RASM80/SmartRelayController/images/README.md

overview

sms_test

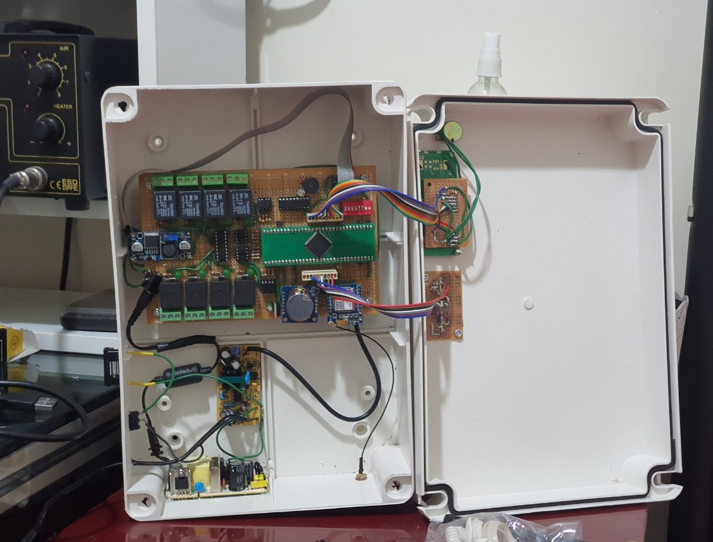
[picture p4: images/package.jpg]
packaging


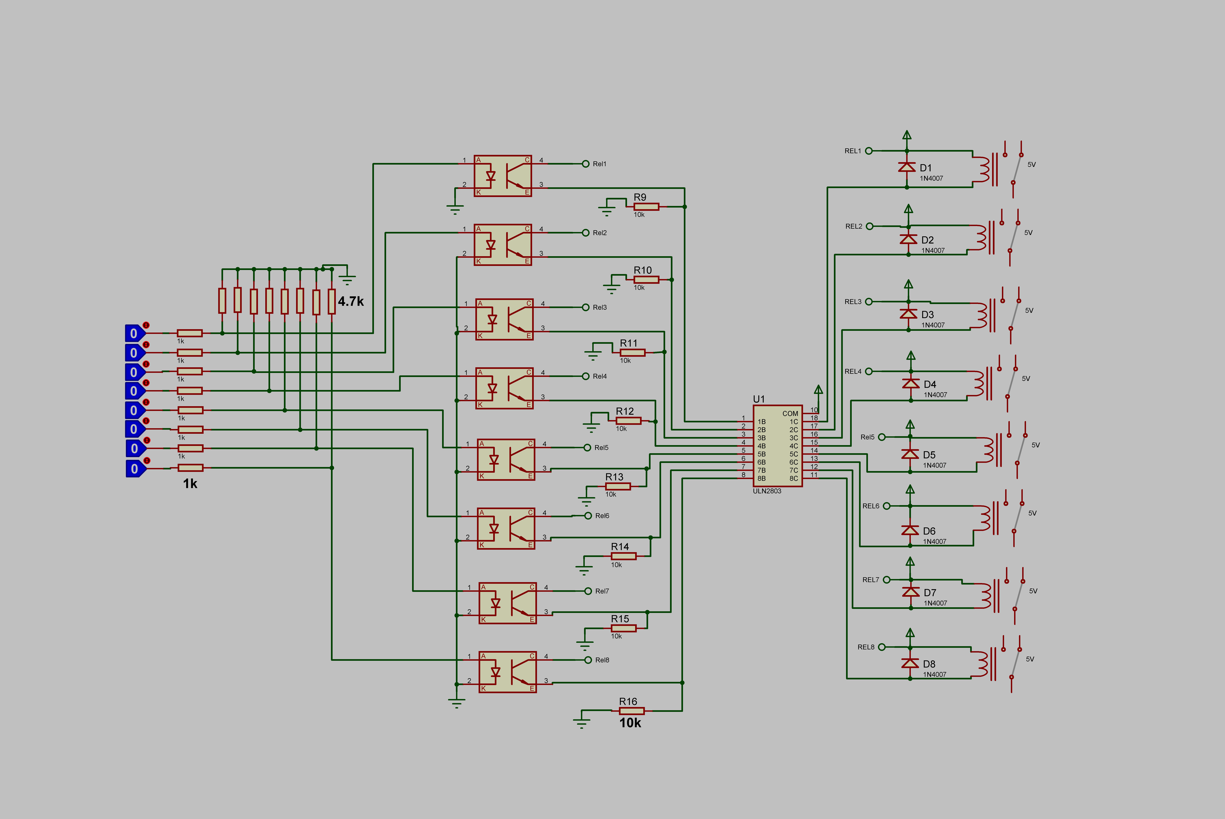
[picture p5: images/relay_board_schem.jpg]
relay_scheme


main_prot
