RASM80/SmartRelayController/hardware/proteus/relay_module_schamtics/README.md

**note**: Opto-couplers(PC817) are added to the circuit for safety and isolate two sides. (Control board and relays)

prot
