RASM80/SmartRelayController/hardware/proteus/main_schematic/README.md

prot
