RASM80/SmartRelayController/(list of files, drawings)

Other design files:
hardware/proteus/main_schematic/main_schem.pdsprj
hardware/proteus/relay_module_schamtics/relay.pdsprj
