RASM80/SmartRelayController/src/main/Initialize.c

void initialize(){

    DDRA=(1<<DDA7) | (1<<DDA6) | (1<<DDA5) | (1<<DDA4) | (1<<DDA3) | (1<<DDA2) | (1<<DDA1) | (1<<DDA0);
    PORTA=(0<<PORTA7) | (0<<PORTA6) | (0<<PORTA5) | (0<<PORTA4) | (0<<PORTA3) | (0<<PORTA2) | (0<<PORTA1) | (0<<PORTA0);
    DDRB=(1<<DDB7) | (1<<DDB6) | (1<<DDB5) | (1<<DDB4) | (1<<DDB3) | (1<<DDB2) | (0<<DDB1) | (1<<DDB0);
    PORTB=(0<<PORTB7) | (0<<PORTB6) | (0<<PORTB5) | (0<<PORTB4) | (0<<PORTB3) | (0<<PORTB2) | (0<<PORTB1) | (0<<PORTB0);
    DDRC=(0<<DDC7) | (1<<DDC6) | (1<<DDC5) | (1<<DDC4) | (0<<DDC3) | (0<<DDC2) | (1<<DDC1) | (1<<DDC0);
    PORTC=(0<<PORTC7) | (1<<PORTC6) | (0<<PORTC5) | (0<<PORTC4) | (0<<PORTC3) | (0<<PORTC2) | (0<<PORTC1) | (0<<PORTC0);
    DDRD=(1<<DDD7) | (1<<DDD6) | (1<<DDD5) | (1<<DDD4) | (0<<DDD3) | (0<<DDD2) | (0<<DDD1) | (0<<DDD0);
    PORTD=(0<<PORTD7) | (0<<PORTD6) | (0<<PORTD5) | (0<<PORTD4) | (0<<PORTD3) | (0<<PORTD2) | (0<<PORTD1) | (0<<PORTD0);
    DDRE=(0<<DDE7) | (0<<DDE6) | (0<<DDE5) | (0<<DDE4) | (0<<DDE3) | (0<<DDE2) | (0<<DDE1) | (0<<DDE0);
    PORTE=(1<<PORTE7) | (0<<PORTE6) | (1<<PORTE5) | (0<<PORTE4) | (0<<PORTE3) | (0<<PORTE2) | (0<<PORTE1) | (0<<PORTE0);
    DDRF=(0<<DDF7) | (0<<DDF6) | (0<<DDF5) | (0<<DDF4) | (0<<DDF3) | (0<<DDF2) | (0<<DDF1) | (0<<DDF0);
    PORTF=(0<<PORTF7) | (0<<PORTF6) | (0<<PORTF5) | (0<<PORTF4) | (0<<PORTF3) | (0<<PORTF2) | (0<<PORTF1) | (0<<PORTF0);
    DDRG=(0<<DDG4) | (0<<DDG3) | (1<<DDG2) | (1<<DDG1) | (1<<DDG0);
    PORTG=(0<<PORTG4) | (0<<PORTG3) | (0<<PORTG2) | (0<<PORTG1) | (0<<PORTG0);


    // External Interrupt(s) initialization
    // INT0: Off
    // INT1: Off
    // INT2: Off
    // INT3: Off
    // INT4: Off
    // INT5: Off
    // INT6: Off
    // INT7: On
    // INT7 Mode: Falling Edge
    EICRA=(0<<ISC31) | (0<<ISC30) | (0<<ISC21) | (0<<ISC20) | (1<<ISC11) | (1<<ISC10) | (1<<ISC01) | (0<<ISC00);
    EICRB=(1<<ISC71) | (0<<ISC70) | (0<<ISC61) | (0<<ISC60) | (0<<ISC51) | (1<<ISC50) | (0<<ISC41) | (0<<ISC40);
    EIMSK=(1<<INT7) | (0<<INT6) | (1<<INT5) | (0<<INT4) | (0<<INT3) | (0<<INT2) | (1<<INT1) | (1<<INT0);
    EIFR=(1<<INTF7) | (0<<INTF6) | (1<<INTF5) | (0<<INTF4) | (0<<INTF3) | (0<<INTF2) | (1<<INTF1) | (1<<INTF0);
    

    // USART0 initialization
    // Communication Parameters: 8 Data, 1 Stop, No Parity
    // USART0 Receiver: On
    // USART0 Transmitter: On
    // USART0 Mode: Asynchronous
    // USART0 Baud Rate: 9600
    UCSR0A=(0<<RXC0) | (0<<TXC0) | (0<<UDRE0) | (0<<FE0) | (0<<DOR0) | (0<<UPE0) | (0<<U2X0) | (0<<MPCM0);
    UCSR0B=(1<<RXCIE0) | (1<<TXCIE0) | (0<<UDRIE0) | (1<<RXEN0) | (1<<TXEN0) | (0<<UCSZ02) | (0<<RXB80) | (0<<TXB80);
    UCSR0C=(0<<UMSEL0) | (0<<UPM01) | (0<<UPM00) | (0<<USBS0) | (1<<UCSZ01) | (1<<UCSZ00) | (0<<UCPOL0);
    UBRR0H=0x00;
    UBRR0L=0x33;

    // USART1 initialization
    // Communication Parameters: 8 Data, 1 Stop, No Parity
    // USART1 Receiver: Off
    // USART1 Transmitter: On
    // USART1 Mode: Asynchronous
    // USART1 Baud Rate: 9600
    UCSR1A=(0<<RXC1) | (0<<TXC1) | (0<<UDRE1) | (0<<FE1) | (0<<DOR1) | (0<<UPE1) | (0<<U2X1) | (0<<MPCM1);
    UCSR1B=(0<<RXCIE1) | (1<<TXCIE1) | (0<<UDRIE1) | (0<<RXEN1) | (1<<TXEN1) | (0<<UCSZ12) | (0<<RXB81) | (0<<TXB81);
    UCSR1C=(0<<UMSEL1) | (0<<UPM11) | (0<<UPM10) | (0<<USBS1) | (1<<UCSZ11) | (1<<UCSZ10) | (0<<UCPOL1);
    UBRR1H=0x00;
    UBRR1L=0x33;

    // Analog Comparator initialization
    // Analog Comparator: Off
    // The Analog Comparator's positive input is
    // connected to the AIN0 pin
    // The Analog Comparator's negative input is
    // connected to the AIN1 pin
    ACSR=(1<<ACD) | (0<<ACBG) | (0<<ACO) | (0<<ACI) | (0<<ACIE) | (0<<ACIC) | (0<<ACIS1) | (0<<ACIS0);
    SFIOR=(0<<ACME);

    // ADC initialization
    // ADC disabled
    ADCSRA=(0<<ADEN) | (0<<ADSC) | (0<<ADFR) | (0<<ADIF) | (0<<ADIE) | (0<<ADPS2) | (0<<ADPS1) | (0<<ADPS0);

    // SPI initialization
    // SPI disabled
    SPCR=(0<<SPIE) | (0<<SPE) | (0<<DORD) | (0<<MSTR) | (0<<CPOL) | (0<<CPHA) | (0<<SPR1) | (0<<SPR0);


    // bool-Banged I2C Bus initialization
    // bool Rate: 100 kHz
    // Note: I2C settings are specified in the
    // Project|Configure|C Compiler|Libraries|I2C menu.
    i2c_init();

    // DS1307 Real Time Clock initialization
    // Square wave output on pin SQW/OUT: Off
    // SQW/OUT pin state: 0
    rtc_init(0,0,0);

    // 1 Wire Bus initialization
    // Note: 1 Wire port settings are specified in the
    // Project|Configure|C Compiler|Libraries|1 Wire menu.
    w1_init();
    
    ds18b20_init(0, -5 , 80, 12);
    // Alphanumeric LCD initialization
    // Connections are specified in the
    // Project|Configure|C Compiler|Libraries|Alphanumeric LCD menu:
    // RS - PORTC bool 0
    // RD - PORTC bool 1
    // EN - PORTC bool 2
    // D4 - PORTC bool 4
    // D5 - PORTC bool 5
    // D6 - PORTC bool 6
    // D7 - PORTC bool 7
    // Characters/line: 16
    lcd_init(16);


}


void initialize_gets_timeout_timer(){
    // Timer/Counter 1 initialization
    // Clock source: System Clock
    // Clock value: 31.250 kHz
    // Mode: Normal top=0xFFFF
    // OC1A output: Disconnected
    // OC1B output: Disconnected
    // OC1C output: Disconnected
    // Noise Canceler: Off
    // Input Capture on Falling Edge
    // Timer Period: 1.1 s
    // Timer1 Overflow Interrupt: On
    // Input Capture Interrupt: Off
    // Compare A Match Interrupt: Off
    // Compare B Match Interrupt: Off
    // Compare C Match Interrupt: Off
    TCCR1A=(0<<COM1A1) | (0<<COM1A0) | (0<<COM1B1) |     (0<<COM1B0) | (0<<COM1C1) | (0<<COM1C0) | (0<<WGM11) | (0<<WGM10);
    TCCR1B=(0<<ICNC1) | (0<<ICES1) | (0<<WGM13) | (0<<WGM12) | (1<<CS12) | (0<<CS11) | (0<<CS10);
    TCNT1H=0x79;
    TCNT1L=0xB9;
    ICR1H=0x00;
    ICR1L=0x00;
    OCR1AH=0x00;
    OCR1AL=0x00;
    OCR1BH=0x00;
    OCR1BL=0x00;
    OCR1CH=0x00;
    OCR1CL=0x00;
    
    // Timer(s)/Counter(s) Interrupt(s) initialization
    TIMSK=(0<<OCIE2) | (0<<TOIE2) | (0<<TICIE1) | (0<<OCIE1A) | (0<<OCIE1B) | (1<<TOIE1) | (0<<OCIE0) | (0<<TOIE0);
}


void initialize_timers(){
    // Timer/Counter 0 initialization
    // Clock source: System Clock
    // Clock value: Timer 0 Stopped
    // Mode: Normal top=0xFF
    // OC0 output: Disconnected
    ASSR=0<<AS0;
    TCCR0=(0<<WGM00) | (0<<COM01) | (0<<COM00) | (0<<WGM01) | (0<<CS02) | (0<<CS01) | (0<<CS00);
    TCNT0=0x00;
    OCR0=0x00;

    // Timer/Counter 2 initialization
    // Clock source: System Clock
    // Clock value: OFF
    // Mode: Normal top=0xFF
    // OC2 output: Disconnected
    // Timer Period: 0
    TCCR2=(0<<WGM20) | (0<<COM21) | (0<<COM20) | (0<<WGM21) | (0<<CS22) | (0<<CS21) | (0<<CS20);
    TCNT2=0x00;
    OCR2=0x00;

    // Timer/Counter 3 initialization
    // Clock source: System Clock
    // Clock value: 7.813 kHz
    // Mode: Normal top=0xFFFF
    // OC3A output: Disconnected
    // OC3B output: Disconnected
    // OC3C output: Disconnected
    // Noise Canceler: Off
    // Input Capture on Falling Edge
    // Timer Period: 0.99994 s
    // Timer3 Overflow Interrupt: On
    // Input Capture Interrupt: Off
    // Compare A Match Interrupt: Off
    // Compare B Match Interrupt: Off
    // Compare C Match Interrupt: Off
    TCCR3A=(0<<COM3A1) | (0<<COM3A0) | (0<<COM3B1) | (0<<COM3B0) | (0<<COM3C1) | (0<<COM3C0) | (0<<WGM31) | (0<<WGM30);
    TCCR3B=(0<<ICNC3) | (0<<ICES3) | (0<<WGM33) | (0<<WGM32) | (1<<CS32) | (0<<CS31) | (1<<CS30);
    TCNT3H=0xE1;
    TCNT3L=0x7C;
    ICR3H=0x00;
    ICR3L=0x00;
    OCR3AH=0x00;
    OCR3AL=0x00;
    OCR3BH=0x00;
    OCR3BL=0x00;
    OCR3CH=0x00;
    OCR3CL=0x00;

    // Timer(s)/Counter(s) Interrupt(s) initialization
    ETIMSK=(0<<TICIE3) | (0<<OCIE3A) | (0<<OCIE3B) | (1<<TOIE3) | (0<<OCIE3C) | (0<<OCIE1C);
    TIFR = 0b01000000;
    return;
}


void initialize_debug_flag(){
    
    if( TSTBIT(PINE, 5) )
        debugFlag = false;
    else
        debugFlag = true;
    return;
}


void initialize_lcd_interface(){

    init_button_timer(off);
    CLRBIT(PORTC, 5);   //turn off lcd light
    lcd_light_state = false;
    reset_menu();
    lcd_light_timeout = 0;
 
}
